Quetrix/Proyecto-Circuito-Vertical-de-Canicas-STM32/docs/Informe Proyecto Final Micros.pdf

# Proyecto: Circuito Vertical de Canicas con Comunicacion por Protocolo RS232 ´

Esteban Vargas Monge
2022208944

Bernardo Chacon Montero
2022053512

Emily Flores Rojas
2021475927

Ismael Bermudez Mora
2022000119

Resumen—Este proyecto presenta un sistema mecatronico ´ para el transporte vertical de canicas, compuesto por una estructura modular, motores a paso y control distribuido entre una Raspberry Pi y un microcontrolador STM32 mediante RS232. Se implementaron modos de operacion manual y programado, ´ con validacion de movimientos y control en tiempo real usando ´ interrupciones. Aunque algunas funciones automaticas no se ´ completaron debido a limitaciones mecanicas, el sistema cumple ´ los objetivos principales y demuestra un funcionamiento estable y coordinado entre hardware y software.
Index Terms—Control Automatico, Mecatr ´ | onica, Motores a ´
Paso, Raspberry Pi, STM32, UART.
I. INTRODUCCION´
El desarrollo de sistemas mecatronicos integrados requiere ´
la convergencia de componentes mecanicos, electr ´ | onicos y de ´
software capaces de trabajar en conjunto de forma precisa y confiable. Bajo este enfoque, se disen˜o un sistema de transpor- ´ te vertical de canicas cuyo proposito es desplazar una canasta ´ dentro de una matriz mediante motores a paso controlados
electronicamente y coordinados a trav ´ | es de comunicaci ´ | on´
serial RS232. Este proyecto combina una estructura f´ısica construida con piezas Lego Technic —elegidas por su modularidad, disponibilidad y facilidad de modificacion— junto ´ con un sistema de control distribuido entre una Raspberry Pi y un microcontrolador STM32.
La Raspberry Pi funciona como unidad de alto nivel, ejecutando una interfaz grafica en Python que permite se- ´ leccionar rutas, definir secuencias de movimiento y validar desplazamientos antes de enviarlos al microcontrolador. Por su parte, el STM32 se encarga del control en tiempo real mediante interrupciones, administrando los motores a paso, el servomotor y la comunicacion UART sin bloquear el sistema. ´ Esta arquitectura facilita la ejecucion precisa de movimientos ´ verticales y horizontales mientras se mantiene una comunicacion continua y eficiente entre los dispositivos. ´
Para facilitar la colaboracion y el desarrollo ´ | agil, se cre ´ | o´
un repositorio en GitHub. Esto resulto de gran utilidad para ´ trabajar desde distintos dispositivos y enviar cambios a la Raspberry Pi rapidamente, permitiendo que todos los inte- ´ grantes del grupo actualizaran el codigo de manera eficiente ´ y centralizada.
El sistema ofrece tres modos de operacion: uno manual, en ´ el cual el usuario interactua directamente con los controles ´ direccionales, otro programado, que permite crear secuencias
completas de movimientos automaticos y uno de calibraci ´ | | on. ´
Aunque algunas funcionalidades, como las zonas de carga automatizadas, no fueron implementadas por limitaciones en el diseno inicial, el proyecto logra integrar de manera efectiva los ˜ elementos esenciales de un sistema mecatronico de transporte ´ controlado.

II. ENFOQUE E IMPLEMENTACION´

II-A. Estructura Mecanica y Materiales ´

Para los requisitos mecanicos, se plante ´ | o una estructura ´
parecida a la que tendr´ıa una impresora 3D, utilizando motores a paso, correas dentadas y llantas. Los materiales utilizados para el desarrollo del proyecto fueron:
3 motores a paso 28BYJ-48 con modulo controlador ´ ULN2003.
Estructura principal construida con piezas LEGO Technic.
1 Servomotor para la apertura de la canasta.
1 motor DC para el tornillo sinf´ın (elevador de canicas). 2 sensores ultrasonicos para el conteo de canicas. ´ Raspberry Pi 5.
STM32 Nucleo F446RE.
Los motores a paso fueron elegidos porque son actuadores digitales que tienen mejor precision que un motor DC; cada ´
impulso electrico mueve el motor a una posici ´ | on o “paso” sin ´
necesidad de un sensor que este monitoreando constantemente ´
[1]. Ademas, no tienen las limitaciones f ´ | ´ısicas que presentan
muchos servomotores y su precio es bastante accesible.
Las correas dentadas se colocaron de forma vertical a ambos lados de la matriz principal de la estructura. Con los motores a paso, estas correas permiten mover la canasta hacia arriba o
hacia abajo segun se necesite. A este sistema se le a ´ | nade una ˜
llanta que se desplaza horizontalmente sobre una barra unida a las correas, logrando as´ı el movimiento lateral requerido. Por razones de presupuesto y disponibilidad, se decidio´ construir la estructura usando piezas Lego Technic (Fig. 1).
Esto resulto ideal por su facilidad de implementaci ´ | on, dispo- ´
nibilidad y capacidad de expansion. ´

II-B. Interfaz y Logica (Raspberry Pi) ´

El software de la interfaz se desarrollo en Python y est ´ | a´
pensado para ejecutarse en la Raspberry Pi. Este programa implementa los modos de movimiento y maneja la comunicacion con el microcontrolador STM32. La clase principal, ´ MarbleInterfaceFinal, contiene todo el comportamiento del sistema.

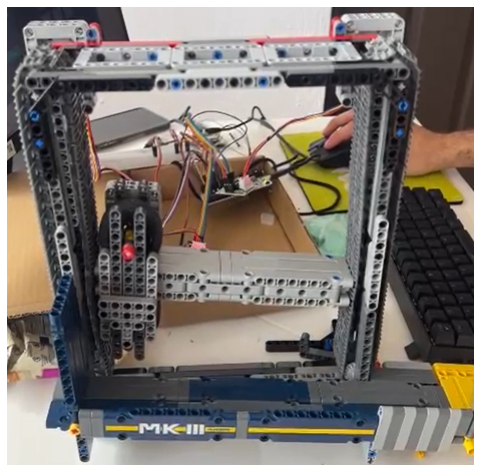
[picture p1: figure]

Figura 1. Estructura mecanica implementada. ´

II-B1. Modo Manual: En el modo manual, el usuario tiene
botones de direccion. Cada vez que se presiona un bot ´ | on, se ´
valida si el movimiento es posible dentro de la matriz y se

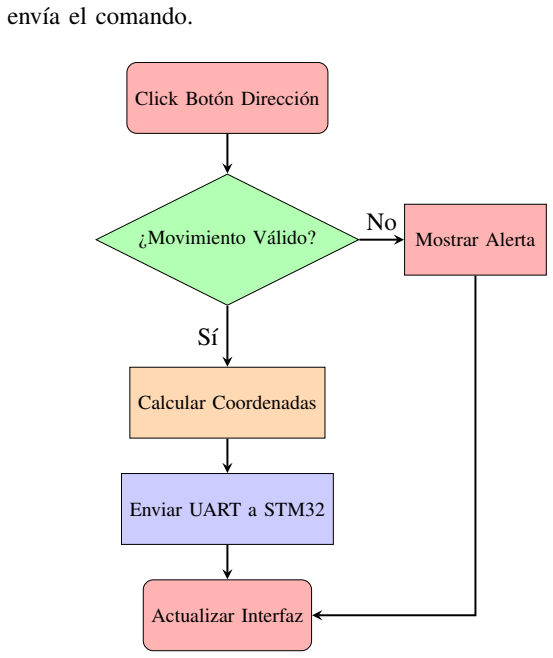
[picture p2: figure]
env´ıa el comando.; Click Boton Direcci ´; ¿Movimiento Valido? ´; Calcular Coordenadas; Enviar UART a STM32; Actualizar Interfaz; Mostrar Alerta

Figura 2. Diagrama de Flujo: Modo Manual.

II-B2. Modo Programado: En el modo programado, el usuario construye rutas seleccionando zonas. El sistema ejecuta automaticamente las acciones recorriendo la lista de pasos. ´

II-C. Firmware y Conexiones (STM32)

El STM32 trabaja en tiempo real, ejecutando los movimientos mientras la Raspberry Pi solo env´ıa ordenes. Se utilizan ´ interrupciones UART para recibir comandos sin bloquear el movimiento de los motores [2]. La conexion de pines utilizada ´ se detalla a continuacion: ´

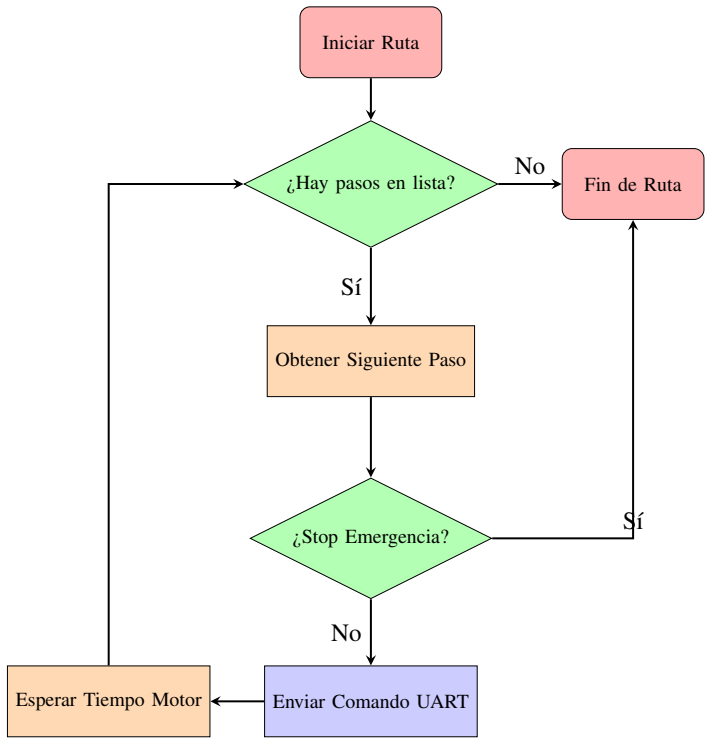
[picture p3: figure]
Iniciar Ruta; ¿Hay pasos en lista?; Obtener Siguiente Paso; ¿Stop Emergencia?; Esperar Tiempo Motor; Enviar Comando UART; Fin de Ruta

Figura 3. Diagrama de Flujo: Modo Programado.

Cuadro I
CONEXION DE PINES ENTRE ´ | STM32 Y ACTUADORES
Actuador | Funcion´ | Pines STM32
Motor 0 | Horizontal (X) | PA0, PA1, PA4, PB0
Motor 1 | Vertical Izq. | PA5, PA6, PA7, PA8
Motor 2 | Vertical Der. | PB4, PA10, PB3, PB1
Servomotor | Volcado | PB6 (TIM4 CH1)

III. ANALISIS ´

En este proyecto, las interrupciones en el STM32 resultaron indispensables. El sistema necesita que los motores a paso avancen en intervalos de tiempo muy espec´ıficos, y ademas se ´ debe llevar el conteo de canicas y recibir comandos al mismo tiempo. Si se hubiera usado polling, podr´ıan haberse perdido pasos o datos de comunicacion. ´
Las pruebas de validacion se realizaron inicialmente en- ´ viando senales individuales a cada motor para confirmar el ˜ cableado y la secuencia de pasos. Posteriormente, se probo el ´
sistema en ”modo simulacion”dentro del c ´ | odigo, comprobando ´
que la logica de la interfaz enviaba los comandos correctos ´ antes de conectar la potencia.
Durante las pruebas integrales, se comprobo que la parte ´
electrica y el protocolo de comunicaci ´ | on funcionan correc- ´
tamente sin latencia perceptible. Sin embargo, se identifico´
un problema mecanico importante: una p ´ | erdida gradual de ´
altura en el eje vertical debido a la diferencia de tension y ´
fuerza entre las dos correas laterales. Aunque el codigo env ´ | ´ıa

la cantidad correcta de pasos, la f´ısica de la estructura provoca que la canasta no siempre alcance la altura teorica tras varios ´
movimientos. En una iteracion futura, se deber ´ | ´ıa medir esta
perdida y modificar el c ´ | odigo para a ´ | nadir una compensaci ˜ | on´
automatica en la subida. ´

IV. CONCLUSIONES
El desarrollo de este proyecto integro exitosamente compo- ´
nentes mecanicos, electr ´ | onicos y de software. El dise ´ | no final ˜
cumple con los requisitos solicitados y ofrece un funcionamiento estable.
La construccion con Lego Technic y motores a paso re- ´
sulto ser una soluci ´ | on modular y accesible, aunque present ´ | o´
retos mecanicos. La interfaz en la Raspberry Pi demostr ´ | o ser ´
intuitiva y robusta para controlar el sistema, mientras que el
STM32 manejo con precisi ´ | on los tiempos cr ´ | ´ıticos mediante
interrupciones, validando la arquitectura distribuida elegida para este sistema mecatronico. ´
V. RECOMENDACIONES
Si se realizara de nuevo este proyecto, se invertir´ıa en motores con mayor torque (como NEMA 17) en lugar de los 28BYJ-48, para evitar perdidas de pasos bajo carga y mejorar ´
la velocidad. Tambien se trabajar ´ | ´ıa con un modelo a mayor
escala para facilitar la manipulacion de componentes. ´ Finalmente, se recomienda mantener un orden estricto en la programacion y utilizar control de versiones (como Git) desde ´ el inicio del proyecto, ya que esto facilito enormemente la ´ integracion del trabajo de los diferentes miembros del equipo. ´

REFERENCIAS

[1] V. V. Athani, Stepper Motors: Fundamentals, Applica-
| tions and Design, Referencia tecnica sobre motores paso ´
a paso, 2014.
[2] STM32F446xx Reference Manual, Documentacion oficial ´
| del protocolo y perifericos, STMicroelectronics, 2024. ´
[3] STM32CubeIDE User Guide, Gu´ıa de usuario del entorno de desarrollo integrado STM32CubeIDE, STMicroelectronics, 2024.
[4] STM32 Microcontrollers Overview, Informacion general ´ y hojas de datos de la familia de microcontroladores STM32, STMicroelectronics, 2024.
[5] Getting started with STM32Cube MCU Package and HAL, Gu´ıa de uso de la capa de abstraccion de hardware ´ (HAL/LL) para STM32, STMicroelectronics, 2024.
