Quetrix/Proyecto-Circuito-Vertical-de-Canicas-STM32/simulation/README.md

# Simulación Interactiva (Prototipo Web)

Esta carpeta contiene la simulación lógica del sistema de canicas. Es una herramienta visual desarrollada en HTML5 y JavaScript puro para validar la lógica de movimiento, el sistema de inventario y las reglas de la máquina de estados antes de implementarlas en el hardware.

## Ver Online
Puedes probar la simulación directamente en tu navegador sin descargar nada haciendo click aquí:

👉 **[Probar Simulación](https://htmlpreview.github.io/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)**

---

## Características
* **Lógica de Grid 3x3:** Valida movimientos legales e ilegales.
* **Inventario:** Gestión de canicas entre el Estañón y la Mano.
* **Modo Planificación:** Permite crear rutas y ejecutarlas paso a paso.
* **Animación de Retorno:** Simula el reciclaje de canicas hacia el estañón.
