Quetrix/Proyecto-Circuito-Vertical-de-Canicas-STM32/motores-test/pinout.png

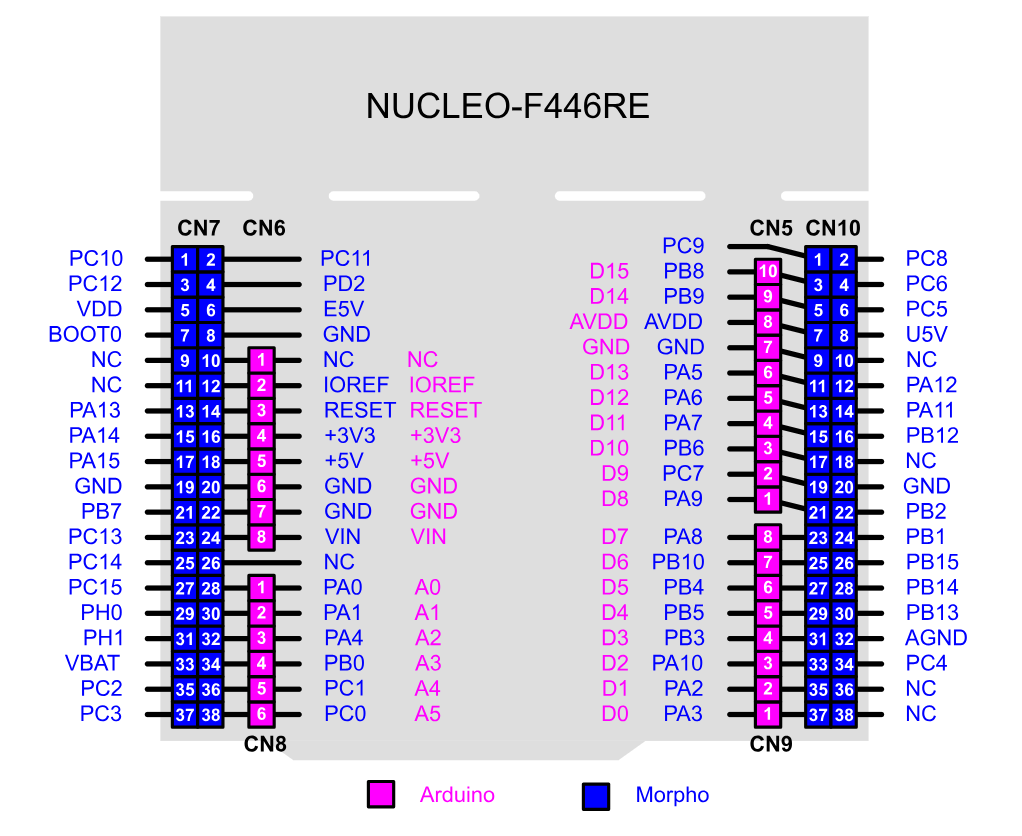
motores-test/pinout.png
