Quetrix/Proyecto-Circuito-Vertical-de-Canicas-STM32/proyecto-canicas-stm32/Core/Src/main.c

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
/* Includes ------------------------------------------------------------------*/
#include "main.h"

/* USER CODE BEGIN Includes */
#include <string.h>
#include <stdlib.h>
#include <stdio.h>
#include <stdbool.h>
/* USER CODE END Includes */

TIM_HandleTypeDef htim2;
TIM_HandleTypeDef htim3;
TIM_HandleTypeDef htim4;

UART_HandleTypeDef huart2;

/* USER CODE BEGIN PV */

// --- VARIABLES UART ---
#define RX_BUFFER_SIZE 32
uint8_t rx_byte;               // Donde cae el byte que acaba de llegar
uint8_t rx_buffer[RX_BUFFER_SIZE]; // Donde armamos la frase completa
uint8_t rx_index = 0;          // Posición actual en el buffer
volatile uint8_t comando_listo = 0; // Bandera: 1 = ¡Llegó una orden completa!
/* USER CODE END PV */

void SystemClock_Config(void);
static void MX_GPIO_Init(void);
static void MX_USART2_UART_Init(void);
static void MX_TIM2_Init(void);
static void MX_TIM4_Init(void);
static void MX_TIM3_Init(void);
/* USER CODE BEGIN 0 */
// ESTA SECCIÓN AHORA CONTIENE TODAS LAS DEFINICIONES GLOBALES DE MOTORES Y EL SERVO

// --- VARIABLES DE ESTADO ---
volatile int32_t pasos_restantes_horiz = 0;

volatile int32_t pasos_restantes_v_izq = 0; // Motor M1
volatile int32_t pasos_restantes_v_der = 0; // Motor M2

// --- CONTADOR DE CANICAS (DOS SENSORES HC-SR04) ---

int canicasEntrada  = 0;
int canicasSalida   = 0;
int canicasActuales = 0;

bool canicaDetectada1 = false;
bool canicaDetectada2 = false;

const int distanciaSinCanica = 20;
const int umbralDeteccion    = 5;
const int distanciaMinima    = 2;

uint32_t tiempoUltimaDeteccion1 = 0;
uint32_t tiempoUltimaDeteccion2 = 0;
const uint32_t tiempoEspera     = 500;

uint32_t tiempoUltimaMuestra    = 0;
const uint32_t intervaloMuestreo = 100;

uint32_t tiempoUltimoEstado     = 0;
const uint32_t intervaloEstado  = 2000;


// Índices de paso actuales (0-7) para cada motor
volatile int8_t idx_h = 0;
volatile int8_t idx_vL = 0;
volatile int8_t idx_vR = 0;

// Secuencia Half-Step (8 pasos)
const uint8_t sequence[8][4] = {
  {1,0,0,0}, {1,1,0,0}, {0,1,0,0}, {0,1,1,0},
  {0,0,1,0}, {0,0,1,1}, {0,0,0,1}, {1,0,0,1}
};

// --- SERVO CONFIG ---
#define SERVO_MIN_PULSE 500
#define SERVO_MAX_PULSE 2500
#define SERVO_ANGULO_CERRADO 65  // Posición de reposo/transporte
#define SERVO_ANGULO_ABIERTO 25  // Posición de volcado


void stepper_write(int motor_id, int step_index) {
    const uint8_t* p = sequence[step_index % 8];

    // Motor 0: Horizontal (PA0, PA1, PA4, PB0)
    if(motor_id == 0) {
        HAL_GPIO_WritePin(GPIOA, GPIO_PIN_0, p[0]?GPIO_PIN_SET:GPIO_PIN_RESET);
        HAL_GPIO_WritePin(GPIOA, GPIO_PIN_1, p[1]?GPIO_PIN_SET:GPIO_PIN_RESET);
        HAL_GPIO_WritePin(GPIOA, GPIO_PIN_4, p[2]?GPIO_PIN_SET:GPIO_PIN_RESET);
        HAL_GPIO_WritePin(GPIOB, GPIO_PIN_0, p[3]?GPIO_PIN_SET:GPIO_PIN_RESET);
    }
    // Motor 1: Vertical Izquierdo (PA5, PA6, PA7, PA8)
    else if(motor_id == 1) {
        HAL_GPIO_WritePin(GPIOA, GPIO_PIN_5, p[0]?GPIO_PIN_SET:GPIO_PIN_RESET);
        HAL_GPIO_WritePin(GPIOA, GPIO_PIN_6, p[1]?GPIO_PIN_SET:GPIO_PIN_RESET);
        HAL_GPIO_WritePin(GPIOA, GPIO_PIN_7, p[2]?GPIO_PIN_SET:GPIO_PIN_RESET);
        HAL_GPIO_WritePin(GPIOA, GPIO_PIN_8, p[3]?GPIO_PIN_SET:GPIO_PIN_RESET);
    }
    // Motor 2: Vertical Derecho (PB1, PB2, PB3, PB4)
    else if(motor_id == 2) {
        HAL_GPIO_WritePin(GPIOB, GPIO_PIN_1, p[0]?GPIO_PIN_SET:GPIO_PIN_RESET);
        HAL_GPIO_WritePin(GPIOB, GPIO_PIN_2, p[1]?GPIO_PIN_SET:GPIO_PIN_RESET);
        HAL_GPIO_WritePin(GPIOB, GPIO_PIN_3, p[2]?GPIO_PIN_SET:GPIO_PIN_RESET);
        HAL_GPIO_WritePin(GPIOB, GPIO_PIN_4, p[3]?GPIO_PIN_SET:GPIO_PIN_RESET);
    }
}

void Mover_Horizontal(int32_t pasos) {
    pasos_restantes_horiz = pasos; // + Derecha, - Izquierda
}

// Mover AMBOS (Comando V normal)
void Mover_Vertical_Sync(int32_t pasos) {
    pasos_restantes_v_izq = pasos;
    pasos_restantes_v_der = pasos;
}

// Mover SOLO IZQUIERDA (Nuevo Comando L)
void Mover_Vertical_L(int32_t pasos) {
    pasos_restantes_v_izq = pasos;
}

// Mover SOLO DERECHA (Nuevo Comando R)
void Mover_Vertical_R(int32_t pasos) {
    pasos_restantes_v_der = pasos;
}


void Mover_Servo(uint16_t angulo) {
    // Protección de límites físicos (0 a 270)
    if (angulo > 270) angulo = 270;

    // Cálculo del ancho de pulso (Pulse Width)
    // Formula: Pulso = Offset + (Angulo * (Rango / Max_Grados))
    uint32_t pulso = SERVO_MIN_PULSE + (angulo * 2000 / 270);

    // Actualizar el registro CCR1 del Timer 4
    __HAL_TIM_SET_COMPARE(&htim4, TIM_CHANNEL_1, pulso);
}

// --- FUNCIÓN CRÍTICA DE INTERRUPCIÓN ---
void HAL_TIM_PeriodElapsedCallback(TIM_HandleTypeDef *htim) {
    if (htim->Instance == TIM2) {

        // 1. Motor Horizontal (Sin cambios)
        if (pasos_restantes_horiz != 0) {
            int8_t dir = (pasos_restantes_horiz > 0) ? 1 : -1;
            idx_h = (idx_h + 8 + dir) % 8;
            stepper_write(0, idx_h);
            pasos_restantes_horiz -= dir;
        }

        // 2. Motor Vertical IZQUIERDO (M1) - Independiente
        if (pasos_restantes_v_izq != 0) {
            int8_t dir_L = (pasos_restantes_v_izq > 0) ? 1 : -1; // 1=Subir
            idx_vL = (idx_vL + 8 + dir_L) % 8;
            stepper_write(1, idx_vL);
            pasos_restantes_v_izq -= dir_L;
        }

        // 3. Motor Vertical DERECHO (M2) - Independiente
        if (pasos_restantes_v_der != 0) {
            // NOTA: M2 está montado en espejo, su giro físico debe ser opuesto a M1 para subir.
            // Si 'pasos_restantes' es positivo (queremos subir), dir_fisica debe ser negativa.
            int8_t dir_input = (pasos_restantes_v_der > 0) ? 1 : -1;
            int8_t dir_R = -dir_input; // INVERSION FISICA

            idx_vR = (idx_vR + 8 + dir_R) % 8;
            stepper_write(2, idx_vR);
            pasos_restantes_v_der -= dir_input; // Restamos la intención lógica
        }
    }
}

// ================== ULTRASONIDO: MEDICIÓN ==================
//
// Usamos TIM3 como contador a 1 MHz (1 tick = 1 µs).
// TIM3 ya está configurado y arrancado en USER CODE 2.

float MedirDistancia_cm(uint8_t sensor_id)
{
    GPIO_TypeDef *trig_port;
    uint16_t trig_pin;
    GPIO_TypeDef *echo_port;
    uint16_t echo_pin;

    if (sensor_id == 1)
    {
        trig_port = TRIG1_GPIO_Port;
        trig_pin  = TRIG1_Pin;
        echo_port = ECHO1_GPIO_Port;
        echo_pin  = ECHO1_Pin;
    }
    else
    {
        trig_port = TRIG2_GPIO_Port;
        trig_pin  = TRIG2_Pin;
        echo_port = ECHO2_GPIO_Port;
        echo_pin  = ECHO2_Pin;
    }

    // Asegurar TRIG en bajo
    HAL_GPIO_WritePin(trig_port, trig_pin, GPIO_PIN_RESET);
    HAL_Delay(2); // 2 ms para estabilizar

    // Generar pulso de 10 µs en TRIG usando TIM3
    __HAL_TIM_SET_COUNTER(&htim3, 0);
    HAL_GPIO_WritePin(trig_port, trig_pin, GPIO_PIN_SET);
    while (__HAL_TIM_GET_COUNTER(&htim3) < 10); // 10 µs
    HAL_GPIO_WritePin(trig_port, trig_pin, GPIO_PIN_RESET);

    // Esperar flanco de subida en ECHO (máx 30 ms)
    const uint32_t timeout_us = 30000; // 30,000 µs
    __HAL_TIM_SET_COUNTER(&htim3, 0);

    while (HAL_GPIO_ReadPin(echo_port, echo_pin) == GPIO_PIN_RESET)
    {
        if (__HAL_TIM_GET_COUNTER(&htim3) > timeout_us)
        {
            return -1.0f; // Timeout: sin eco
        }
    }

    // Medir tiempo en alto del pulso ECHO
    __HAL_TIM_SET_COUNTER(&htim3, 0);
    while (HAL_GPIO_ReadPin(echo_port, echo_pin) == GPIO_PIN_SET)
    {
        if (__HAL_TIM_GET_COUNTER(&htim3) > timeout_us)
        {
            return -1.0f; // Timeout: pulso demasiado largo
        }
    }

    uint32_t duracion_us = __HAL_TIM_GET_COUNTER(&htim3);

    // Convertir a distancia en cm (velocidad sonido 343 m/s)
    float distancia = (duracion_us * 0.0343f) / 2.0f; // ida y vuelta

    return distancia;
}

// ================== ULTRASONIDO: ENVÍO A RASPBERRY ==================
//
// Formato de mensaje (una línea por evento):
//   #IN,entradas,salidas,actuales\n
//   #OUT,entradas,salidas,actuales\n
//
// La Raspi simplemente escucha y parsea las líneas que empiezan con "#".

void EnviarEventoCanica(const char *tipo)  // tipo = "IN" o "OUT"
{
    char msg[64];
    int len = snprintf(msg, sizeof(msg),
                       "#%s,%d,%d,%d\n",
                       tipo,
                       canicasEntrada,
                       canicasSalida,
                       canicasActuales);

    if (len > 0)
    {
        HAL_UART_Transmit(&huart2, (uint8_t*)msg, (uint16_t)len, 50);
    }
}


/* USER CODE END 0 */

/**
  * @brief  The application entry point.
  * @retval int
  */
int main(void)
{

  /* MCU Configuration--------------------------------------------------------*/

  /* Reset of all peripherals, Initializes the Flash interface and the Systick. */
  HAL_Init();

  /* Configure the system clock */
  SystemClock_Config();

  /* Initialize all configured peripherals */
  MX_GPIO_Init();
  MX_USART2_UART_Init();
  MX_TIM2_Init();
  MX_TIM4_Init();
  MX_TIM3_Init();
  /* USER CODE BEGIN 2 */
    HAL_TIM_Base_Start_IT(&htim2); // Iniciar Timer Pasos
    HAL_TIM_PWM_Start(&htim4, TIM_CHANNEL_1); // Iniciar PWM Servo
    HAL_TIM_Base_Start(&htim3);   // Iniciar TIM3 como contador libre (1 MHz) para ultrasonidos


    HAL_UART_Receive_IT(&huart2, &rx_byte, 1); // Iniciar UART

    // POSICION INICIAL SEGURA (CERRADO = 65 grados)
    Mover_Servo(SERVO_ANGULO_CERRADO);


  /* USER CODE END 2 */

  /* Infinite loop */
  /* USER CODE BEGIN WHILE */
    while (1)
    {
        // ====================== ULTRASONIDO: MEDICIÓN Y CONTEO ======================
        uint32_t ahora = HAL_GetTick();

        // Medimos solo cada 'intervaloMuestreo' ms para no saturar
        if (ahora - tiempoUltimaMuestra >= intervaloMuestreo)
        {
            tiempoUltimaMuestra = ahora;

            // ----- SENSOR 1: ENTRADA -----
            float d1 = MedirDistancia_cm(1);

            if (d1 > 0 &&
                d1 > distanciaMinima &&
                d1 < (distanciaSinCanica - umbralDeteccion))
            {
                // Canica detectada en ENTRADA
                if (!canicaDetectada1 &&
                    (ahora - tiempoUltimaDeteccion1 > tiempoEspera))
                {
                    canicasEntrada++;
                    canicasActuales++;
                    canicaDetectada1 = true;
                    tiempoUltimaDeteccion1 = ahora;

                    EnviarEventoCanica("IN");
                }
            }
            else
            {
                canicaDetectada1 = false;
            }

            // ----- SENSOR 2: SALIDA -----
            float d2 = MedirDistancia_cm(2);

            if (d2 > 0 &&
                d2 > distanciaMinima &&
                d2 < (distanciaSinCanica - umbralDeteccion))
            {
                // Canica detectada en SALIDA
                if (!canicaDetectada2 &&
                    (ahora - tiempoUltimaDeteccion2 > tiempoEspera))
                {
                    canicasSalida++;
                    if (canicasActuales > 0)
                    {
                        canicasActuales--;
                    }
                    canicaDetectada2 = true;
                    tiempoUltimaDeteccion2 = ahora;

                    EnviarEventoCanica("OUT");
                }
            }
            else
            {
                canicaDetectada2 = false;
            }
        }

        // No usar delays aquí; los motores se mueven por TIM2 interrupt
    }
    /* USER CODE END WHILE */

    /* USER CODE BEGIN 3 */
  }
  /* USER CODE END 3 */


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
/* USER CODE BEGIN 4 */
// Callback: Se llama cada vez que llega un byte por UART
void HAL_UART_RxCpltCallback(UART_HandleTypeDef *huart)
{
  // Verificar que la interrupción viene del UART2 (USB)
  if (huart->Instance == USART2)
  {
    // CASO 1: Recibimos el caracter de final de linea ('\n')
    // Aquí es donde procesamos el comando completo
    if (rx_byte == '\n')
    {
      rx_buffer[rx_index] = '\0'; // Terminamos el string
      rx_index = 0;               // Reiniciamos índice para el próximo

      // --- PARSEO DE COMANDOS ---
      char cmd_char = rx_buffer[0];           // La letra (H, V, S)
      int valor = atoi((char*)&rx_buffer[1]); // El número (convertido a int)

      // Ejecutar directamente usando tus funciones existentes
      if (cmd_char == 'H' || cmd_char == 'h')
      {
          Mover_Horizontal(valor);
      }

      else if (cmd_char == 'V' || cmd_char == 'v')
      {
          Mover_Vertical_Sync(valor); // Mueve ambos
      }
      // Solo Izquierda
      else if (cmd_char == 'L' || cmd_char == 'l')
      {
          Mover_Vertical_L(valor);
      }
      // Solo Derecha
      else if (cmd_char == 'R' || cmd_char == 'r')
      {
          Mover_Vertical_R(valor);
      }

      // CONTROL DE SERVO
      else if (cmd_char == 'S' || cmd_char == 's')
      {
          Mover_Servo(valor);
      }

      // --- RESET DE CONTADORES DE CANICAS ---
       else if (cmd_char == 'C' || cmd_char == 'c')
       {
           canicasEntrada  = 0;
           canicasSalida   = 0;
           canicasActuales = 0;
           canicaDetectada1 = false;
           canicaDetectada2 = false;

           // Opcional: notificar a la Raspberry que se ha reseteado
           const char *msg = "#RST\n";
           HAL_UART_Transmit(&huart2, (uint8_t*)msg, strlen(msg), 50);
       }
    }
    // CASO 2: Buffer lleno (Seguridad)
    else if (rx_index >= RX_BUFFER_SIZE - 1)
    {
        rx_index = 0; // Reiniciar si se llena sin recibir \n
    }
    // CASO 3: Recibimos un caracter normal
    else
    {
        // Guardar caracter (ignorando el 'Carriage Return' \r de Windows)
        if(rx_byte != '\r')
        {
            rx_buffer[rx_index++] = rx_byte;
        }
    }

    // IMPORTANTE: Volver a activar la escucha para el siguiente byte SIEMPRE
    HAL_UART_Receive_IT(&huart2, &rx_byte, 1);
  }
}
// ... Las funciones de escritura y movimiento de motores estan en USER CODE 0

// Callback para el Botón de Usuario (PC13)
void HAL_GPIO_EXTI_Callback(uint16_t GPIO_Pin)
{
  if (GPIO_Pin == B1_Pin) // Botón Azul (PC13)
  {
      // 1. FRENADO DE EMERGENCIA
      pasos_restantes_horiz = 0;
      pasos_restantes_v_der = 0;
      pasos_restantes_v_izq = 0;

      
      // 2. SERVO A POSICION SEGURA (Cerrado = 65 grados)
      Mover_Servo(SERVO_ANGULO_CERRADO);
  }
}
/* USER CODE END 4 */
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
