Quetrix/Proyecto-Circuito-Vertical-de-Canicas-STM32/proyecto-canicas-stm32/proyecto-canicas-stm32.ioc

Mcu.UserName=STM32F446RETx
PA0-WKUP.Signal=GPIO_Output
PA1.Signal=GPIO_Output
PA13.GPIO_Label=TMS
PA13.Signal=SYS_JTMS-SWDIO
PA14.GPIO_Label=TCK
PA14.Signal=SYS_JTCK-SWCLK
PA2.GPIO_Label=USART_TX
PA2.Signal=USART2_TX
PA3.GPIO_Label=USART_RX
PA3.Signal=USART2_RX
PA4.Signal=GPIO_Output
PA5.Signal=GPIO_Output
PA6.Signal=GPIO_Output
PA7.Signal=GPIO_Output
PA8.Signal=GPIO_Output
PB0.Signal=GPIO_Output
PB1.Signal=GPIO_Output
PB2.Signal=GPIO_Output
PB3.Signal=GPIO_Output
PB4.Signal=GPIO_Output
PB6.Signal=S_TIM4_CH1
PC0.GPIO_Label=TRIG1
PC0.Signal=GPIO_Output
PC1.GPIO_Label=ECHO1
PC1.Signal=GPIO_Input
PC13.GPIO_Label=B1 [Blue PushButton]
PC13.Signal=GPXTI13
PC14-OSC32_IN.Signal=RCC_OSC32_IN
PC15-OSC32_OUT.Signal=RCC_OSC32_OUT
PC2.GPIO_Label=TRIG2
PC2.Signal=GPIO_Output
PC3.GPIO_Label=ECHO2
PC3.Signal=GPIO_Input
PH0-OSC_IN.Signal=RCC_OSC_IN
PH1-OSC_OUT.Signal=RCC_OSC_OUT
