Quetrix/Proyecto-Circuito-Vertical-de-Canicas-STM32/proyecto-canicas-stm32/Core/Inc/main.h

#define B1_Pin GPIO_PIN_13
#define B1_GPIO_Port GPIOC
#define B1_EXTI_IRQn EXTI15_10_IRQn
#define TRIG1_Pin GPIO_PIN_0
#define TRIG1_GPIO_Port GPIOC
#define ECHO1_Pin GPIO_PIN_1
#define ECHO1_GPIO_Port GPIOC
#define TRIG2_Pin GPIO_PIN_2
#define TRIG2_GPIO_Port GPIOC
#define ECHO2_Pin GPIO_PIN_3
#define ECHO2_GPIO_Port GPIOC
#define USART_TX_Pin GPIO_PIN_2
#define USART_TX_GPIO_Port GPIOA
#define USART_RX_Pin GPIO_PIN_3
#define USART_RX_GPIO_Port GPIOA
#define TMS_Pin GPIO_PIN_13
#define TMS_GPIO_Port GPIOA
#define TCK_Pin GPIO_PIN_14
#define TCK_GPIO_Port GPIOA
