Quetrix/Proyecto-Circuito-Vertical-de-Canicas-STM32/(commit log)

2025-11-22 # Prototipo web interactivo (HTML/JS) para probar lógica
2025-11-22 # Proyecto completo de STM32CubeIDE (Código C)
2025-12-01 Creacion de virtual environment de Python.
2025-12-01 Creacion de prueba serial e instalacion pyserial
2025-12-02 Correccion nombre folder raspberry-pi-app
2025-12-03 Modificaciones al codigo STM32 para controlar servomotor
2025-12-04 Cambios al codigo STM32 para angulos de servomotor
2025-12-04 Update interfaz_canicas-v5.py
    Se actualizo la funcion rutina_volcado_y_retorno de la interfaz para implementar el movimiento del servomotor en lugar de una ventana popup.
2025-12-04 Updated README
    Se actualizaron los archivos README del proyecto general y del firmware STM32
    Se creó un README para la interfaz gráfica
2025-12-04 Update main.c
    Se modifica el main.c del STM32 para separar el movimiento de los motores verticales
2025-12-04 Update main.c
    Cambio de timer TIM2 del STM32.
    Antes: 1000ms
    Ahora: 2000ms
2025-12-05 Se agrega funcion de conteo de canicas al STM32
    Pines utilizados para los sensores de conteo de canicas:
    PC0 Trig1
    PC1 ECHO1
    PC2 Trig2
    PC3 ECHO2
2025-12-05 Update interfaz_canicas-v6.py
    Se agrega la funcionalidad de conteo de canicas con sensores ultrasonido en el microcontrolador.
    Ya la interfaz no agrega canicas automaticamente cuando se acaba un recorrido, sino que usa solamente el conteo de IN vs OUT.
2025-12-05 Timer2 seteado a 2000-1
