Quetrix/Proyecto-Circuito-Vertical-de-Canicas-STM32/(notices)

Notices in the files:
proyecto-canicas-stm32/Core/Inc/main.h:
Copyright (c) 2025 STMicroelectronics.
All rights reserved.
This software is licensed under terms that can be found in the LICENSE file
